lucasovbetts-tech/SayoDevice-O3C-case-model/download/o3c_case_top.step

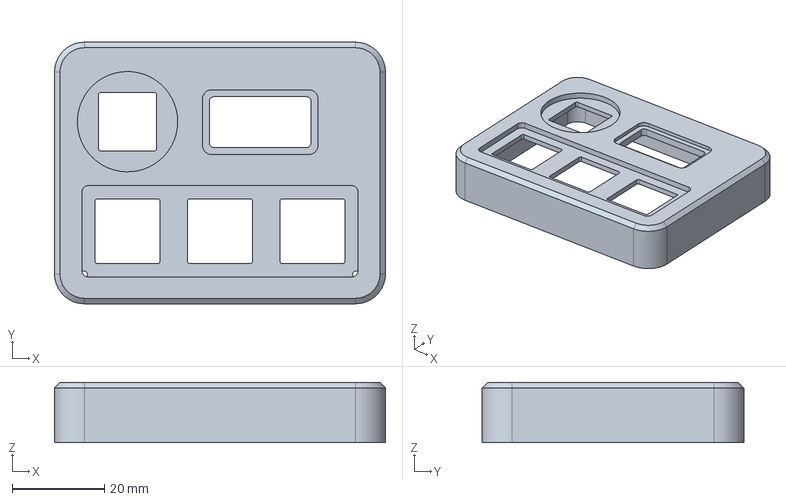
[picture p5: CAD file, 2026-11-02]
download/o3c_case_top.step
71.6 x 56.6 x 13.0 mm
