lucasovbetts-tech/SayoDevice-O3C-case-model/download/o3c_case_bottom.step

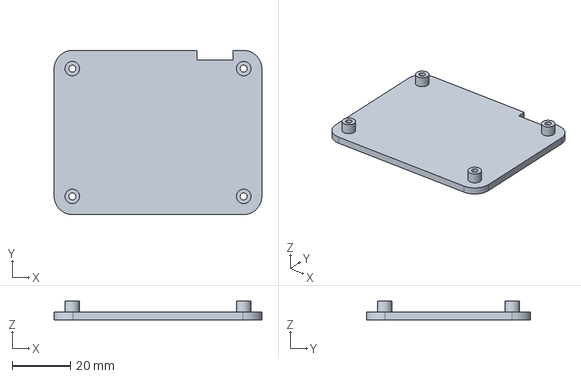
[picture p6: CAD file, 2026-11-02]
download/o3c_case_bottom.step
71.6 x 56.6 x 6.40 mm
