lucasovbetts-tech/SayoDevice-O3C-case-model/(list of files, cad)

Other CAD files:
download/o3c_case_bottom.stl
download/o3c_case_top.stl
