lucasovbetts-tech/SayoDevice-O3C-case-model/(commit log)

2026-11-02 Small updates to measurements + Downloadable files
    [o3c_case_bottom.step, o3c_case_bottom.stl, o3c_case_top.step, o3c_case_top.stl]
2026-11-02 Added pytest tests for case geometry
